Daniyar1239/DIY-Bioreactor/Images/Results_2.PNG

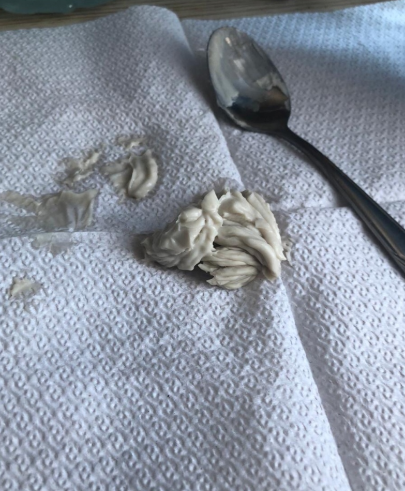
Images/Results_2.PNG
