Daniyar1239/DIY-Bioreactor/Images/Assembly_4.jpeg

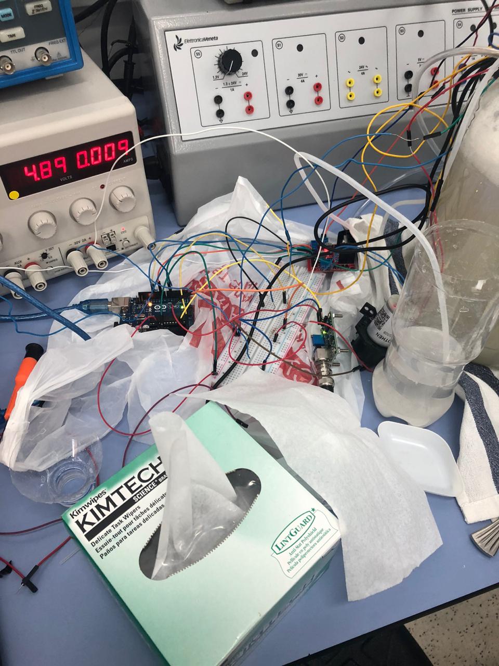
Images/Assembly_4.jpeg
