Daniyar1239/DIY-Bioreactor/Program logic.PNG

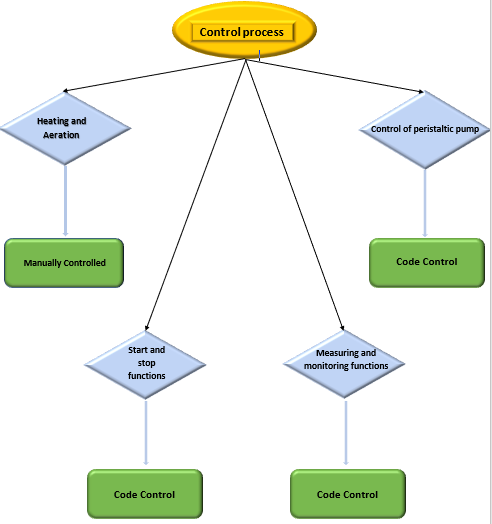
Program logic.PNG
