Daniyar1239/DIY-Bioreactor/Images/Assembly_1.PNG

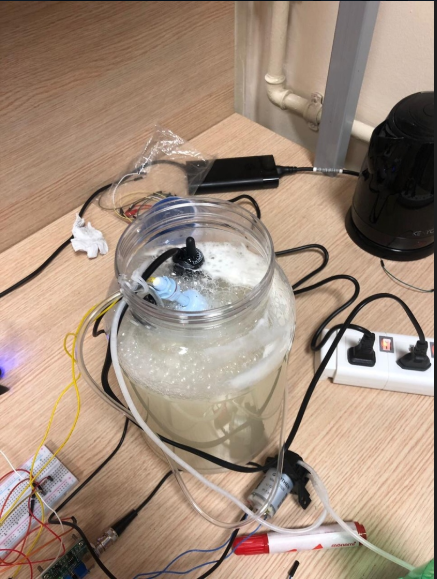
Images/Assembly_1.PNG
