Daniyar1239/DIY-Bioreactor/Images/Assembly_2.jpeg

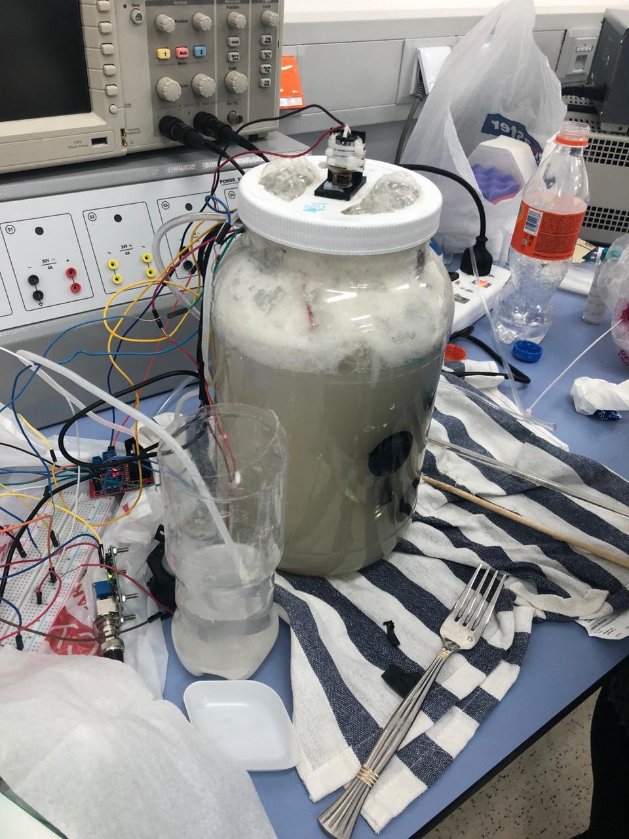
Images/Assembly_2.jpeg
