Daniyar1239/DIY-Bioreactor/Images/Assembly_5.PNG

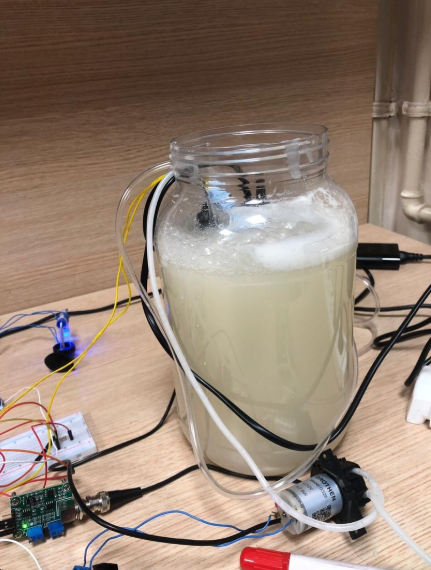
Images/Assembly_5.PNG
