Daniyar1239/DIY-Bioreactor/Images/Results_3.PNG

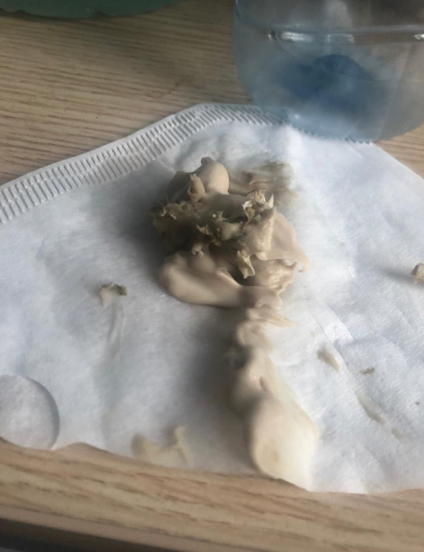
Images/Results_3.PNG
