Daniyar1239/DIY-Bioreactor/Images/Results_4.jpeg

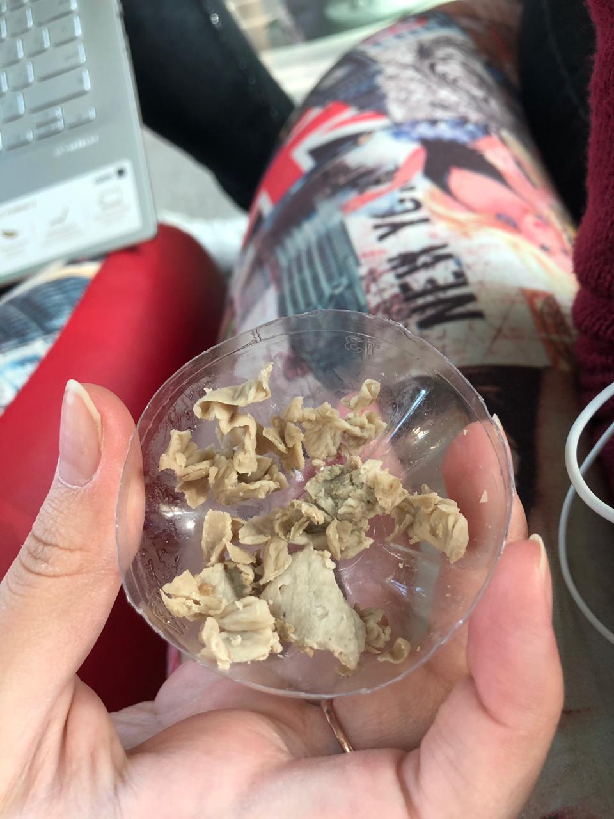
Images/Results_4.jpeg
